Sineos/ADS1220-Klipper-Board/KiCad/ADC_Klipper_Board.pdf

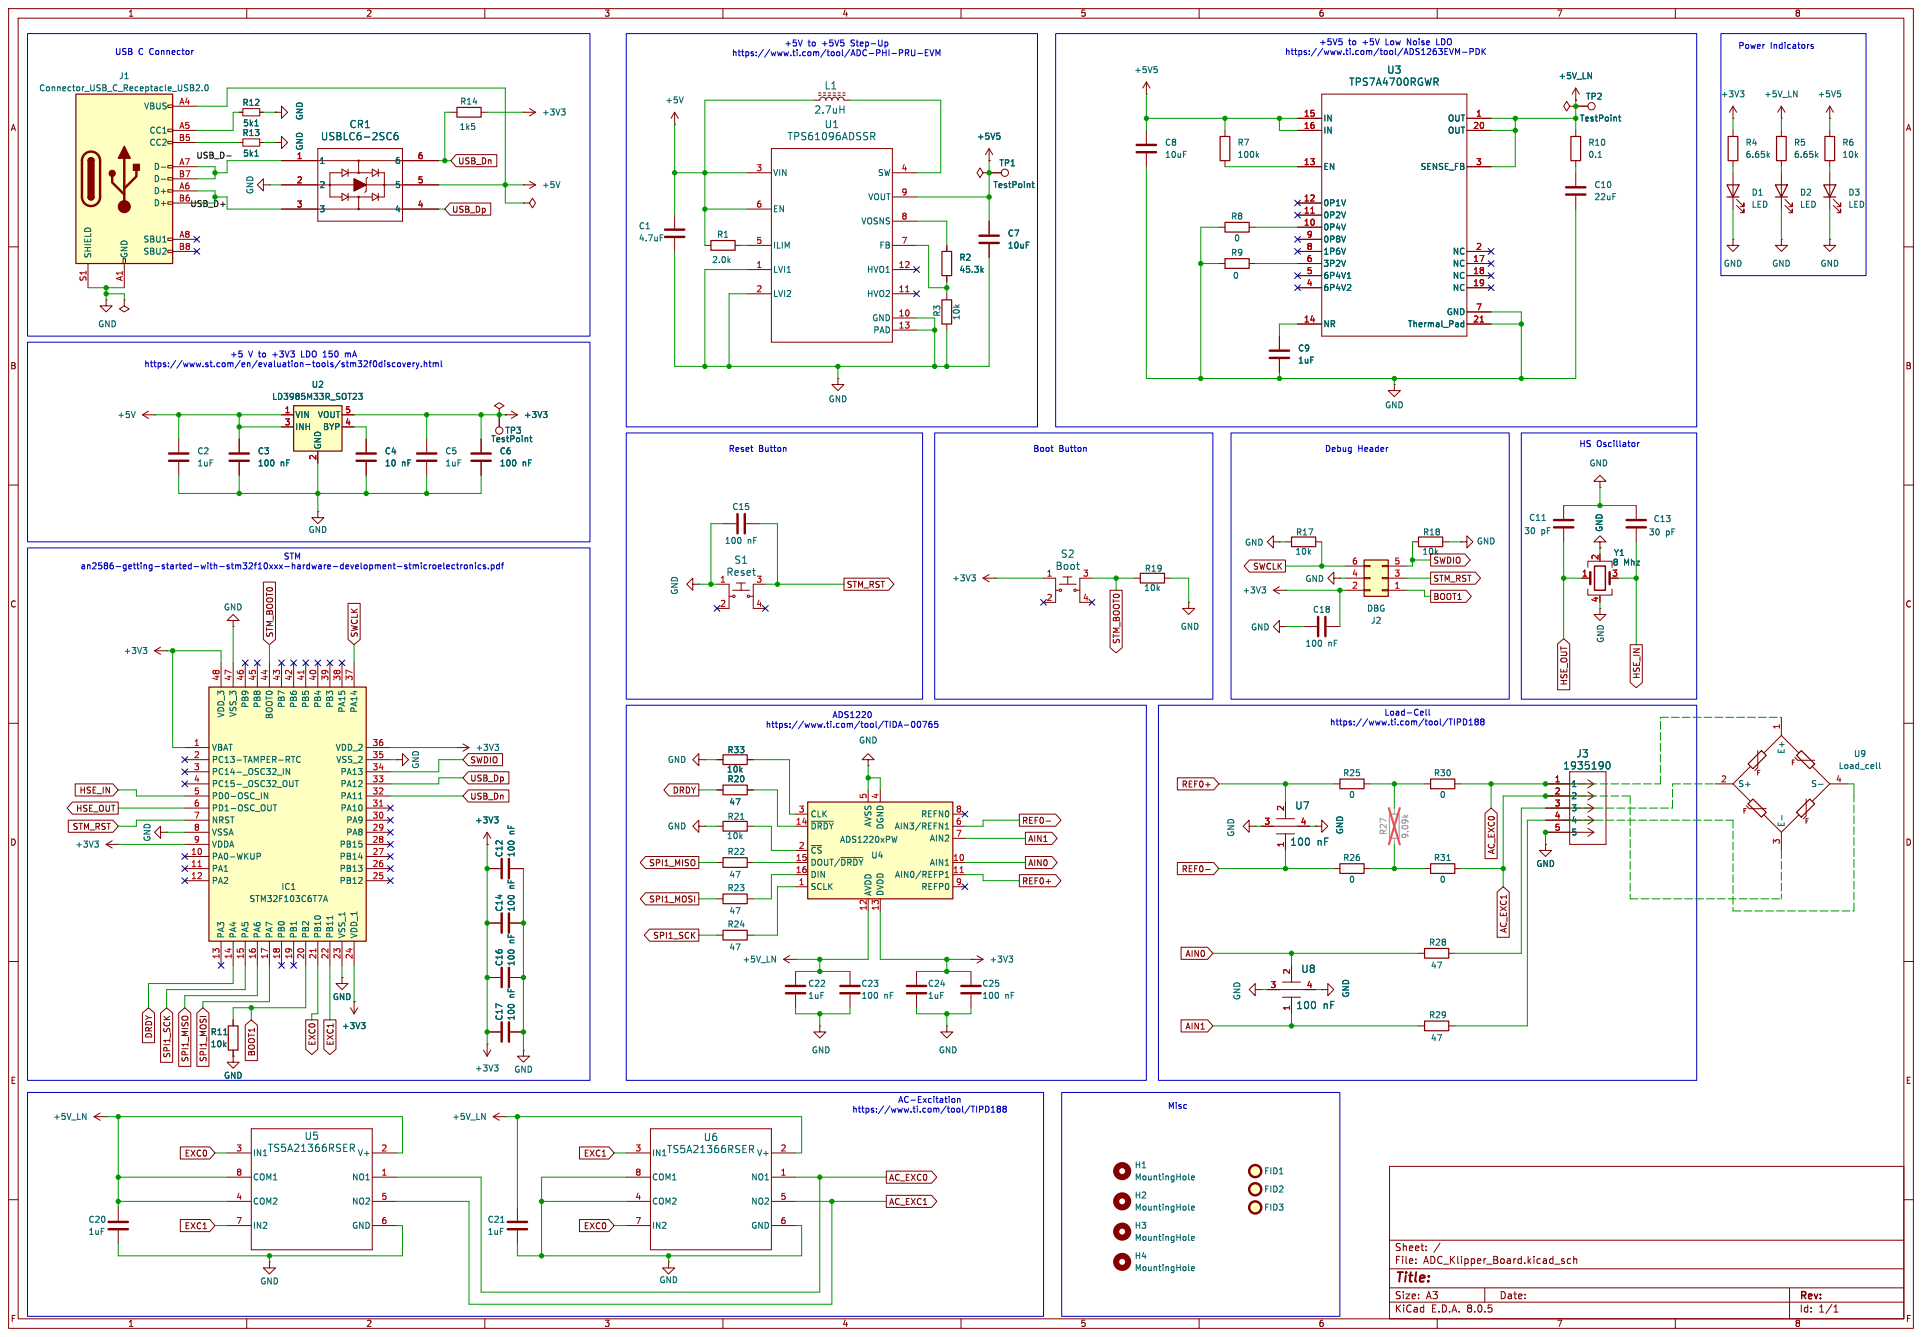
[picture p1: page 1]

https://www.ti.com/tool/ADS1263EVM-PDK

https://www.ti.com/tool/ADC-PHI-PRU-EVM

an2586-getting-started-with-stm32f10xxx-hardware-development-stmicroelectronics.pdf +5 V to +3V3 LDO 150 mA

Load-Cell https://www.ti.com/tool/TIPD188 U7

https://www.ti.com/tool/TIDA-00765

Id: 1/1 Title: File: ADC_Klipper_Board.kicad_sch Sheet: /
