Sineos/ADS1220-Klipper-Board/(list of files, drawings)

Other design files:
KiCad/Altium/ADC_Klipper_Board.PcbDoc
KiCad/Altium/ADC_Klipper_Board.PrjPcb
KiCad/Altium/ADC_Klipper_Board.SchDoc
KiCad/Altium/ADC_Klipper_Board.SchLib
KiCad/Altium/ADC_Klipper_Board_v2.SchLib
KiCad/Altium/Library.PcbLib
