Sineos/ADS1220-Klipper-Board/KiCad/ADC_Klipper_Board.kicad_pcb

## KiCad design KiCad/ADC_Klipper_Board.kicad_pcb (2024-10-25)

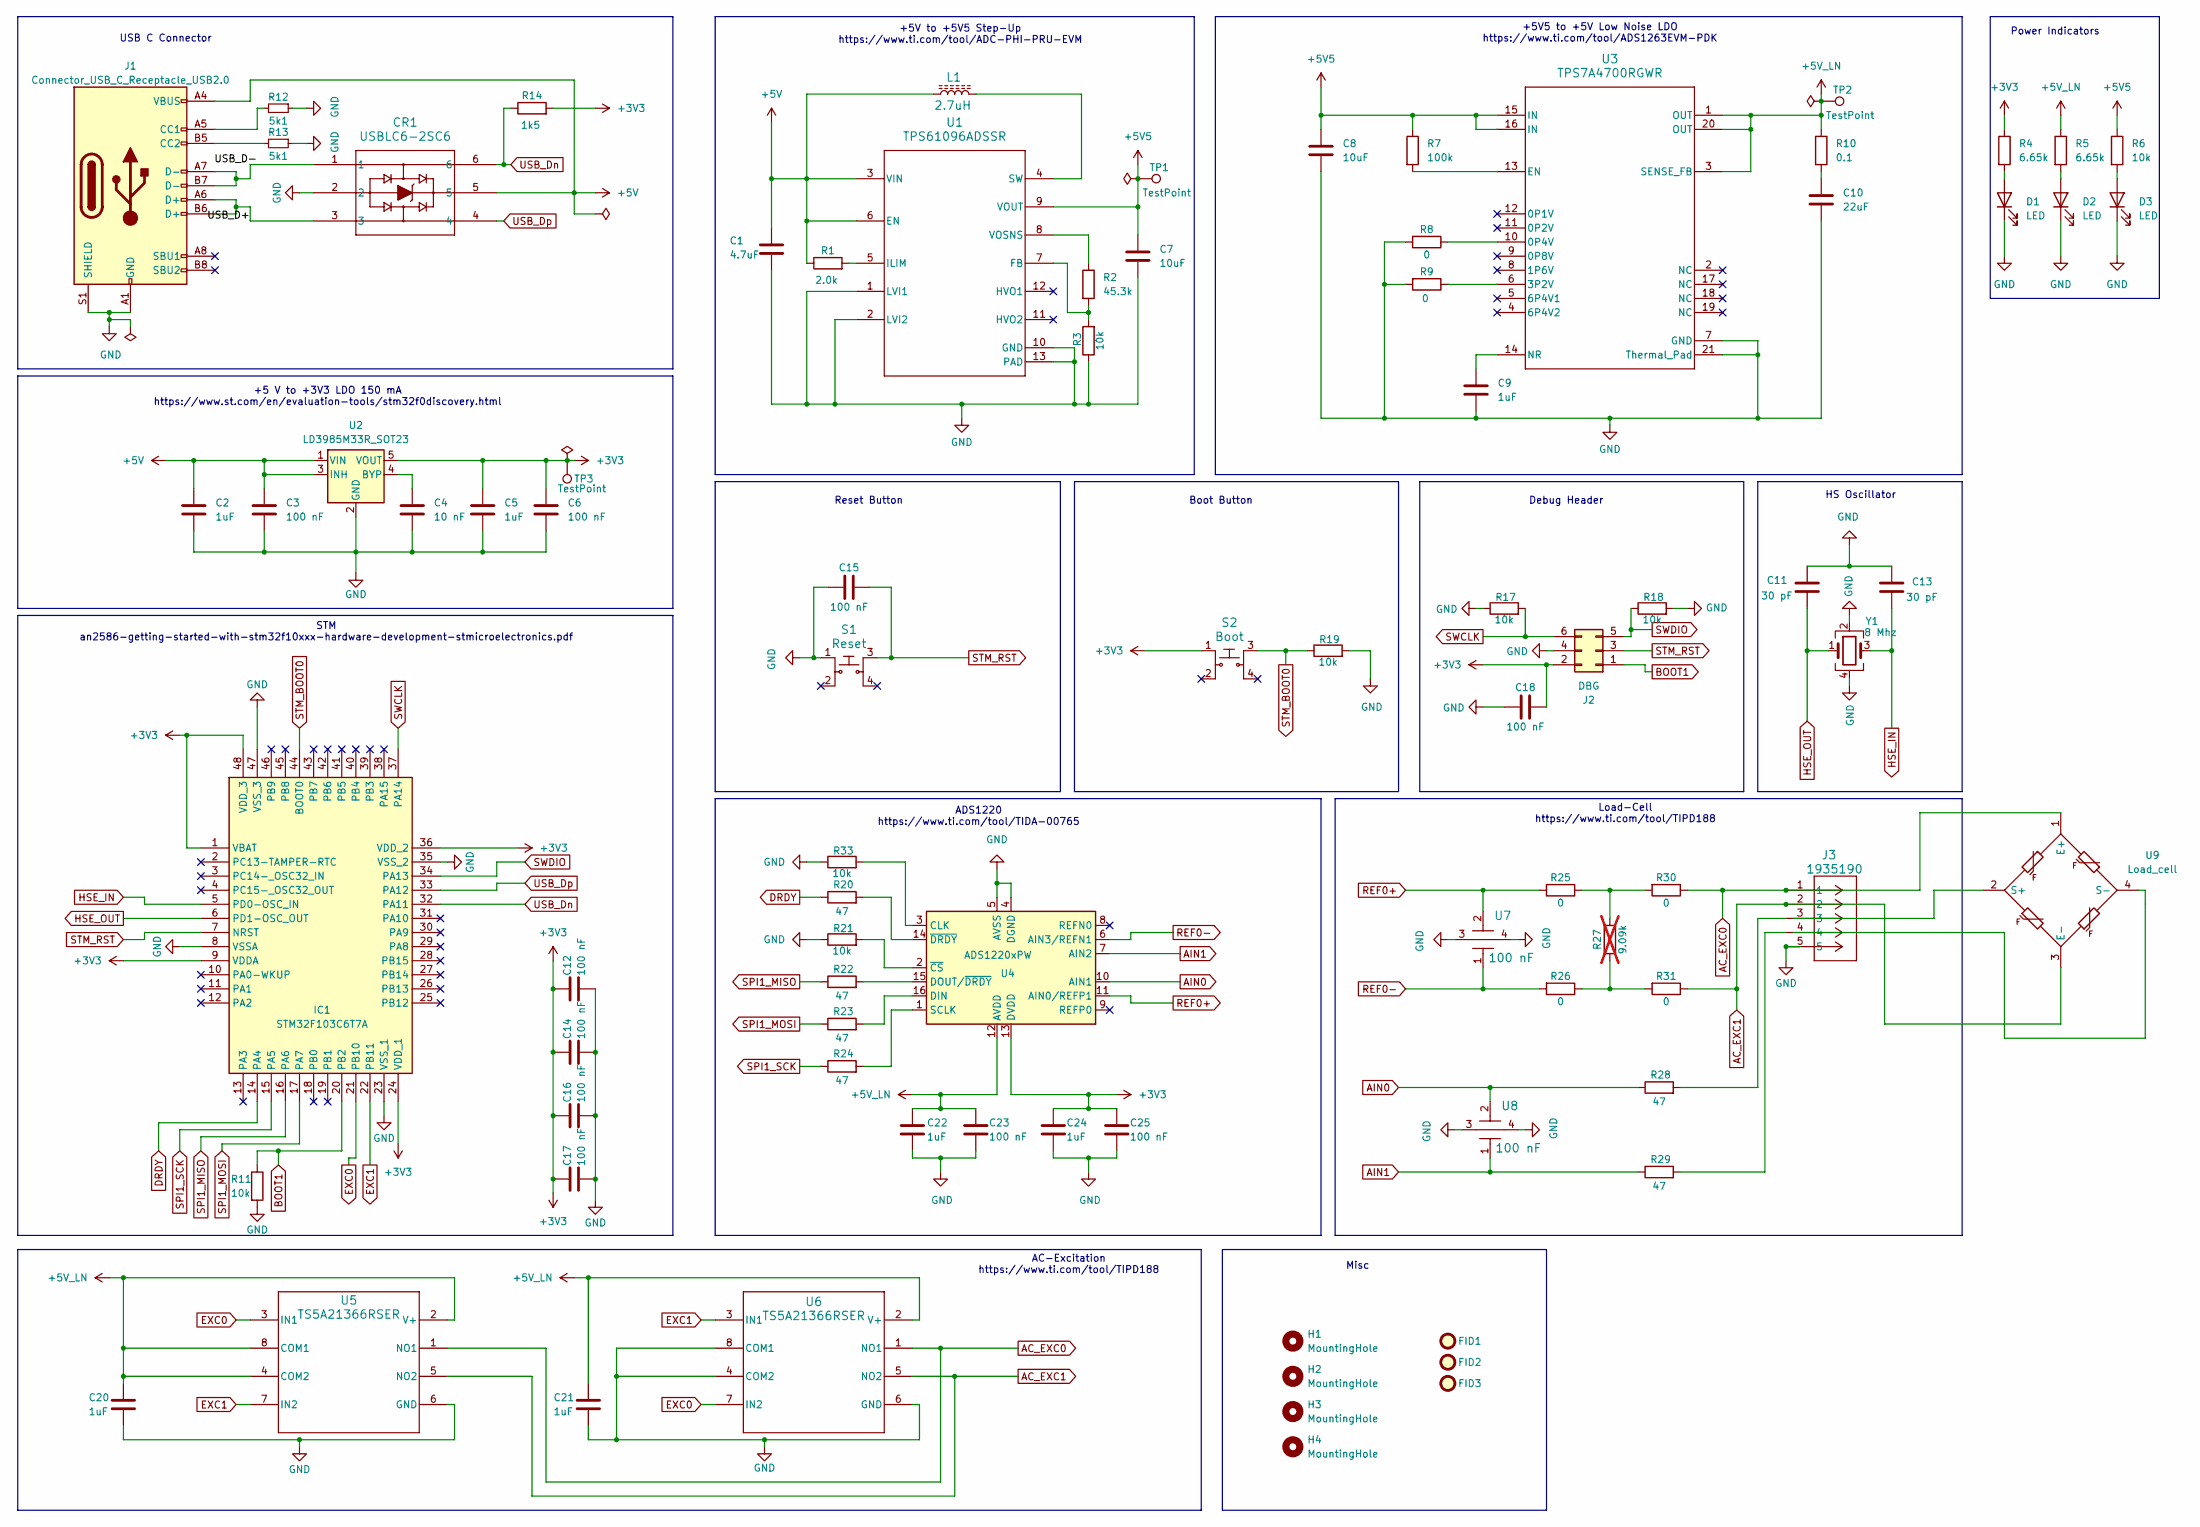
[picture p2: schematic ADC_Klipper_Board.kicad_sch]

Parts:
C1: 4.7uF; C_0805_2012Metric; Manufacturer_Part_Number GRM21BR71A475KE51L; LCSC C415536
C2, C5, C9, C20, C21, C22, C24: 1uF; C_0603_1608Metric; Manufacturer_Part_Number GCJ188R71E105KA01D; LCSC C908553
C3, C6, C12, C14, C15, C16, C17, C18, C23, C25: 100 nF; C_0603_1608Metric; Manufacturer_Part_Number CC0603KRX7R7BB104; LCSC C108079
C4: 10 nF; C_0603_1608Metric; Manufacturer_Part_Number CC0603KRX7R9BB103; LCSC C100042
C7, C8: 10uF; C_1206_3216Metric; Manufacturer_Part_Number C1206C106K3RACTU; LCSC C2168111
C10: 22uF; C_1210_3225Metric; Manufacturer_Part_Number GRM32ER71E226KE15L; LCSC C21397
C11, C13: 30 pF; C_0603_1608Metric; Manufacturer_Part_Number AC0603JRNPO9BN300; LCSC C2191217
CR1: USBLC6-2SC6; SOT23-6L_STM; Manufacturer_Part_Number USBLC6-2SC6; LCSC C2827654
D1, D2, D3: LED; LED_0805_2012Metric; Manufacturer_Part_Number APT2012LZGCK; LCSC C5569446
FID1, FID2, FID3: Fiducial; Fiducial_1mm_Mask2mm
H1, H2, H3, H4: MountingHole; MountingHole_3.2mm_M3_ISO7380
IC1: STM32F103C6T7A; QFP50P900X900X160-48N; Manufacturer_Part_Number STM32F103C6T7A; LCSC C222074
J1: Connector_USB_C_Receptacle_USB2.0; TYPE-C-31-M-12; Manufacturer_Part_Number TYPE-C-31-M-12; LCSC C5337088
J2: DBG; PinHeader_2x03_P2.54mm_Vertical; Manufacturer_Part_Number 2.54-2*3P; LCSC C65114
J3: 1935190; CONN_1935190_PXC; Manufacturer_Part_Number 1935190; LCSC C6047339
L1: 2.7uH; IND_5028_TDK; Manufacturer_Part_Number VLCF5020T-2R7N1R7; LCSC C307836
R1: 2.0k; R_0603_1608Metric; Manufacturer_Part_Number R0603RXX202XF10LTS; LCSC C267576
R2: 45.3k; R_0603_1608Metric; Manufacturer_Part_Number ERJ3EKF4532V; LCSC C403233
R3, R6, R11, R17, R18, R19, R21, R33: 10k; R_0603_1608Metric; Manufacturer_Part_Number RT0603FRE0710KL; LCSC C469659
R4, R5: 6.65k; R_0603_1608Metric; Manufacturer_Part_Number AC0603FR-076K65L; LCSC C228025
R7: 100k; R_0603_1608Metric; Manufacturer_Part_Number RT0603FRE07100KL; LCSC C728638
R8, R9, R25, R26, R30, R31: 0; R_0603_1608Metric; Manufacturer_Part_Number RC0603JR-070RL; LCSC C95177
R10: 0.1; R_0603_1608Metric; Manufacturer_Part_Number UCR03EVPFLR100; LCSC C880952
R12, R13: 5k1; R_0603_1608Metric; Manufacturer_Part_Number CRCW06035K10FKEA; LCSC C844933
R14: 1k5; R_0603_1608Metric; Manufacturer_Part_Number RMC1/16K152FTP; LCSC C340503
R20, R22, R23, R24, R28, R29: 47; R_0603_1608Metric; Manufacturer_Part_Number CRCW060347R0FKEA; LCSC C511383
R27: 9.09k; R_0603_1608Metric; Manufacturer_Part_Number ERJ-3EKF9091V; not fitted
S1: Reset; SWITCH_43SMTR92LFS; Manufacturer_Part_Number PTS645SM43SMTR92; LCSC C221880
S2: Boot; SWITCH_43SMTR92LFS; Manufacturer_Part_Number PTS645SM43SMTR92; LCSC C221880
TP1, TP2, TP3: TestPoint; TestPoint_Pad_D2.0mm
U1: TPS61096ADSSR; DSS0012A; Manufacturer_Part_Number TPS61096ADSSR; LCSC C2862062
U2: LD3985M33R_SOT23; SOT-23-5; Manufacturer_Part_Number LD3985M33R; LCSC C46243
U3: TPS7A4700RGWR; RGW0020A-IPC_A; Manufacturer_Part_Number TPS7A4700RGWR; LCSC C114839
U4: ADS1220xPW; SOP65P640X120-16N; Manufacturer_Part_Number ADS1220xPW; LCSC C48263
U5, U6: TS5A21366RSER; RSE0008A; Manufacturer_Part_Number TS5A21366RSER
U7, U8: 100 nF; X15; Manufacturer_Part_Number 250X15W104MV4E; LCSC C111274
U9: Load_cell
Y1: 8 Mhz; Crystal_SMD_5032-4Pin_5.0x3.2mm; Manufacturer_Part_Number XL1SI-111-8M; LCSC C20617600

Connections:
+3V3: C5.1, C6.1, C12.1, C14.1, C16.1, C17.1, C18.2, C24.1, C25.1, IC1.1 (VBAT), IC1.9 (VDDA), IC1.24 (VDD_1), IC1.36 (VDD_2), IC1.48 (VDD_3), J2.2, R4.1, R14.2, S2.1, TP3.1, U2.5 (VOUT), U4.13 (DVDD)
+5V: C1.1, C2.1, C3.1, CR1.5, J1.A4 (VBUS), J1.A9 (VBUS), J1.B4 (VBUS), J1.B9 (VBUS), L1.1, R1.1, U1.3 (VIN), U1.6 (EN), U2.1 (VIN), U2.3 (INH)
+5V5: C7.1, C8.1, R6.1, R7.1, TP1.1, U1.9 (VOUT), U3.15 (IN), U3.16 (IN)
+5V_LN: C20.1, C21.1, C22.1, C23.1, R5.1, R10.1, TP2.1, U3.1 (OUT), U3.3 (SENSE_FB), U3.20 (OUT), U4.12 (AVDD), U5.2 (V+), U5.4 (COM2), U5.8 (COM1), U6.2 (V+)
/USB_D+: CR1.3, J1.A6 (D+), J1.B6 (D+)
/USB_D-: CR1.1, J1.A7 (D-), J1.B7 (D-)
AC_EXC0: J3.1, R30.1, U5.1 (NO1), U6.1 (NO1), U9.1 (E+)
AC_EXC1: J3.2, R31.1, U5.5 (NO2), U6.5 (NO2), U9.3 (E-)
AIN0: R28.1, U4.10 (AIN1), U8.2
AIN1: R29.1, U4.7 (AIN2), U8.1
BOOT1: IC1.20 (PB2), J2.1, R11.1
DRDY: IC1.14 (PA4), R20.1
EXC0: IC1.21 (PB10), U5.3 (IN1), U6.7 (IN2)
EXC1: IC1.22 (PB11), U5.7 (IN2), U6.3 (IN1)
GND: C1.2, C2.2, C3.2, C4.2, C5.2, C6.2, C7.2, C8.2, C9.2, C10.2, C11.1, C12.2, C13.1, C14.2, C15.1, C16.2, C17.2, C18.1, C20.2, C21.2, C22.2, C23.2, C24.2, C25.2, CR1.2, D1.1 (K), D2.1 (K), D3.1 (K), IC1.8 (VSSA), IC1.23 (VSS_1), IC1.35 (VSS_2), IC1.47 (VSS_3), J1.A1 (GND), J1.A12 (GND), J1.B1 (GND), J1.B12 (GND), J1.S1 (SHIELD), J2.4, J3.5, R3.1, R8.2, R9.2, R11.2, R12.1, R13.1, R17.1, R18.2, R19.2, R21.1, R33.1, S1.1, U1.1 (LVI1), U1.2 (LVI2), U1.10 (GND), U1.13 (PAD), U1.V, U2.2 (GND), U3.7 (GND), U3.21 (Thermal_Pad), U4.4 (DGND), U4.5 (AVSS), U5.6 (GND), U6.4 (COM2), U6.6 (GND), U6.8 (COM1), U7.3, U7.4, U8.3, U8.4, Y1.2, Y1.4
HSE_IN: C13.2, IC1.5 (PD0-OSC_IN), Y1.3
HSE_OUT: C11.2, IC1.6 (PD1-OSC_OUT), Y1.1
unnamed: C10.1, R10.2
unnamed: D1.2 (A), R4.2
unnamed: D2.2 (A), R5.2
unnamed: D3.2 (A), R6.2
unnamed: J1.A5 (CC1), R12.2
unnamed: J1.B5 (CC2), R13.2
unnamed: J3.3, R28.2
unnamed: J3.4, R29.2
unnamed: R25.1, R27.1, R30.2
unnamed: R26.1, R27.2, R31.2
unnamed: R2.2, R3.2, U1.7 (FB)
unnamed: R1.2, U1.5 (ILIM)
unnamed: L1.2, U1.4 (SW)
unnamed: R2.1, U1.8 (VOSNS)
unnamed: C4.1, U2.4 (BYP)
unnamed: R8.1, U3.10 (0P4V)
unnamed: R9.1, U3.6 (3P2V)
unnamed: R7.2, U3.13 (EN)
unnamed: C9.1, U3.14 (NR)
unnamed: R33.2, U4.3 (CLK)
unnamed: R23.2, U4.16 (DIN)
unnamed: R22.2, U4.15 (DOUT/~DRDY)
unnamed: R24.2, U4.1 (SCLK)
unnamed: R21.2, U4.2 (~CS)
unnamed: R20.2, U4.14 (~DRDY)
REF0+: R25.2, U4.11 (AIN0/REFP1), U7.2
REF0-: R26.2, U4.6 (AIN3/REFN1), U7.1
SPI1_MISO: IC1.16 (PA6), R22.1
SPI1_MOSI: IC1.17 (PA7), R23.1
SPI1_SCK: IC1.15 (PA5), R24.1
STM_BOOT0: IC1.44 (BOOT0), R19.1, S2.3
STM_RST: C15.2, IC1.7 (NRST), J2.3, S1.3
SWCLK: IC1.37 (PA14), J2.6, R17.2
SWDIO: IC1.34 (PA13), J2.5, R18.1
USB_Dn: CR1.6, IC1.32 (PA11), R14.1
USB_Dp: CR1.4, IC1.33 (PA12)

Notes on the sheet:
Reset Button
Load-Cell https://www.ti.com/tool/TIPD188
Boot Button
+5V to +5V5 Step-Up https://www.ti.com/tool/ADC-PHI-PRU-EVM
USB C Connector
Misc
ADS1220 https://www.ti.com/tool/TIDA-00765
+5V5 to +5V Low Noise LDO https://www.ti.com/tool/ADS1263EVM-PDK
Debug Header
STM an2586-getting-started-with-stm32f10xxx-hardware-development-stmicroelectronics.pdf
Power Indicators
HS Oscillator
AC-Excitation https://www.ti.com/tool/TIPD188
+5 V to +3V3 LDO 150 mA https://www.st.com/en/evaluation-tools/stm32f0discovery.html

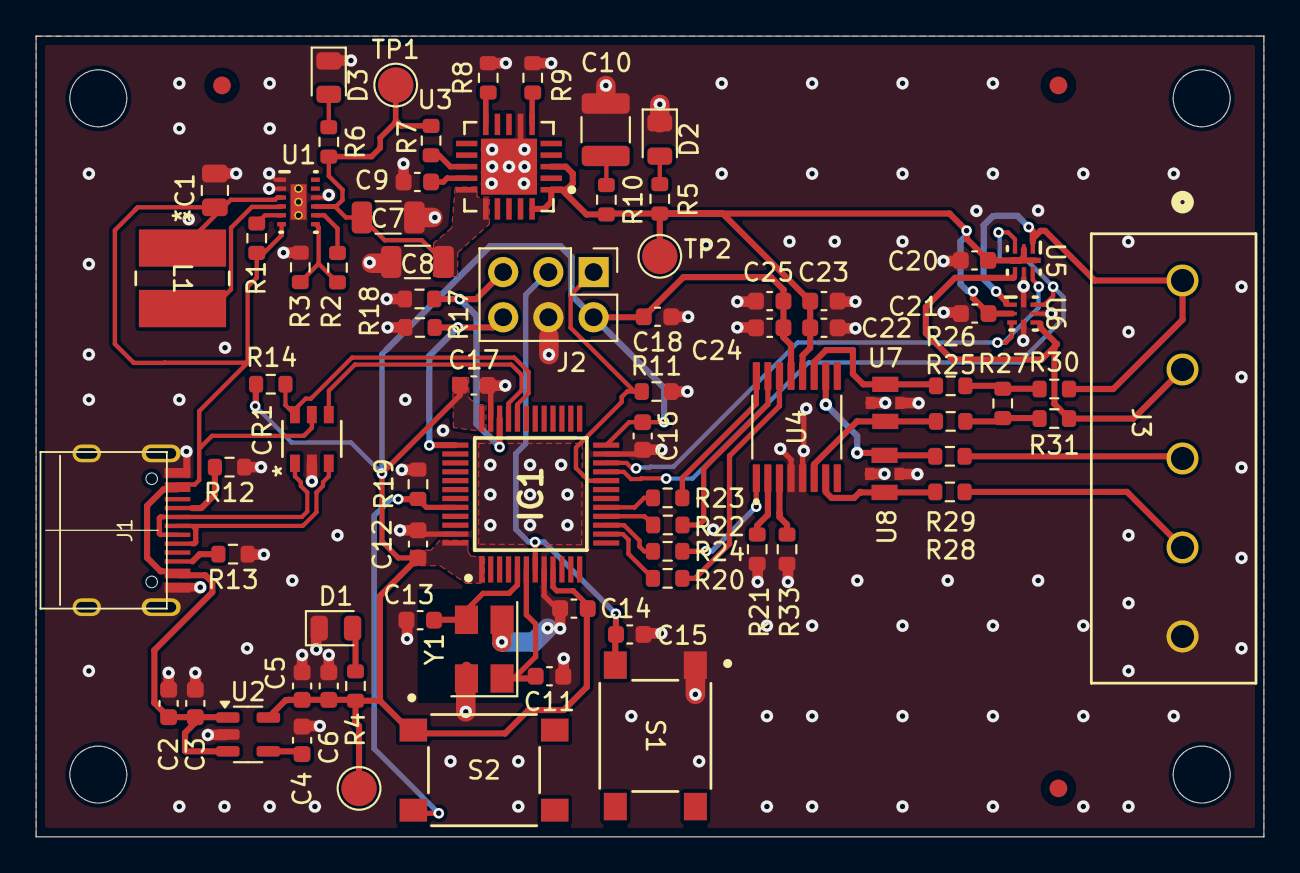
[picture p3: board ADC_Klipper_Board.kicad_pcb from above]

Board: 4 copper layers, 69.0 x 45.0 mm, 84 parts (0 on the bottom side), 53 nets.
